eSpark-Backup/bryangilmore-ups/Design-Files/DC-UPS-v1.0/Deliverables/Renderings/3D_Isometric_View.PNG

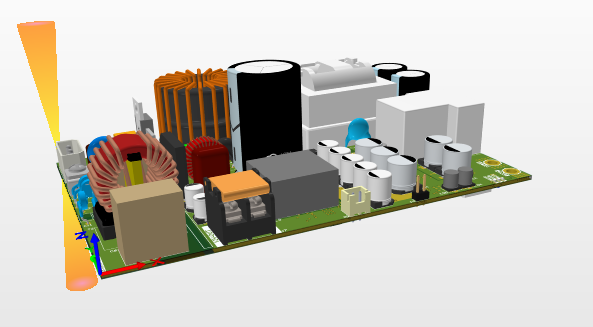
Design-Files/DC-UPS-v1.0/Deliverables/Renderings/3D_Isometric_View.PNG
