eSpark-Backup/bryangilmore-ups/Design-Files/DC-UPS-v1.0/Deliverables/Renderings/3D_Top_View.PNG

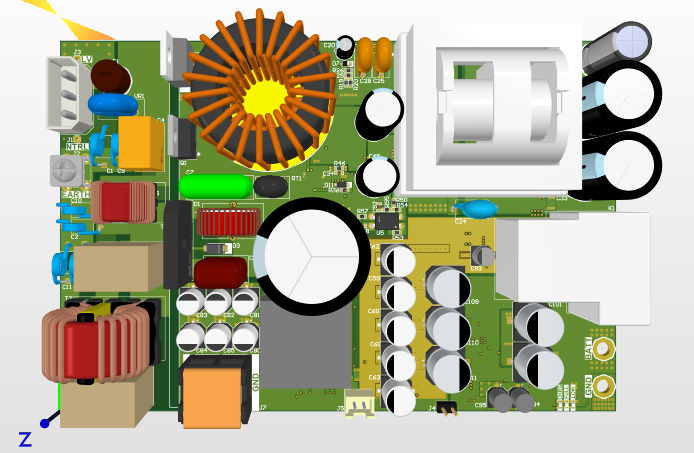
Design-Files/DC-UPS-v1.0/Deliverables/Renderings/3D_Top_View.PNG
