eSpark-Backup/bryangilmore-ups/Design-Files/DC-UPS-v1.0/Deliverables/Renderings/2D_C_View.PNG

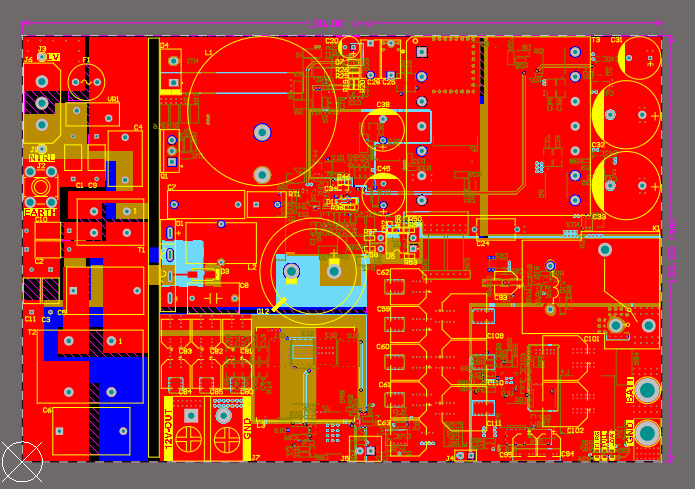
Design-Files/DC-UPS-v1.0/Deliverables/Renderings/2D_C_View.PNG
