eSpark-Backup/bryangilmore-ups/Design-Files/DC-UPS-v1.0/Deliverables/Renderings/2D_SIG+PWR_Layer.PNG

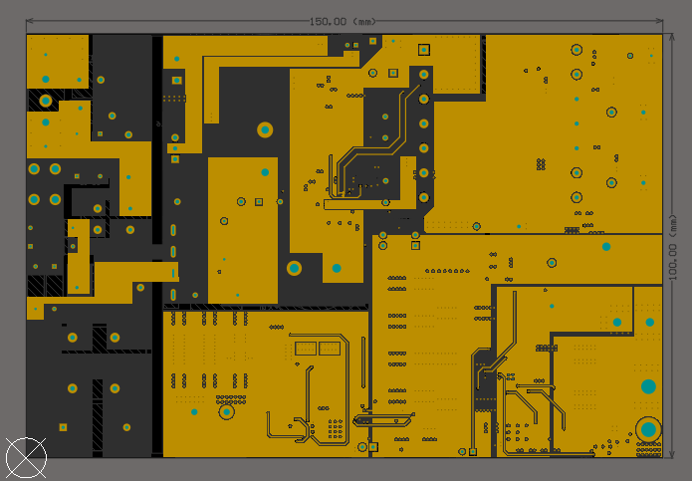
Design-Files/DC-UPS-v1.0/Deliverables/Renderings/2D_SIG+PWR_Layer.PNG
