eSpark-Backup/bryangilmore-ups/Design-Files/DC-UPS-v1.0/Deliverables/BOM/Client-BOM-DC-UPS-v1.0.xlsx

# | Item Type | Designator | Description | Footprint | Manufacturer Part Number | Manufacturer | Value | Quantity | Remarks
1 | Capacitors | C1, C9 | CAP CER 100PF 250V RADIAL | Custom | DE1B3RA101KN4AN01F | Murata | 100pF | 2
2 | Suppression Capacitor | C2, C3, C10, C11 | CAP CER 220PF 250V RADIAL | Custom | DE1B3RA221KN4AN01F | Murata | 220pF | 4
3 | Suppression Capacitor | C4 | 220nF ±10% X2 275V Plugin,P=10mm Suppression Capacitors ROHS | Custom | X2P2224KN1B0130150080ES0 | STE | 220nF | 1
4 | Capacitor | C5, C6 | CAP FILM 0.47UF 10% 560VDC RAD | Custom | R46KI347050M1K | KEMET | 0.47UF | 2
5 | Film Capacitors | C7 | CAP FILM 0.47UF 5% 450VDC RADIAL | Custom | 450MPK474J | Rubycon | 470nF | 1
6 | Capacitor | C8 | 1uF -40℃~+105℃ ±5% 450V Plugin,P=10mm Polypropylene Film Capacitors (CBB) ROHS | Custom | MPP105J2W10KN22605 | KNSCHA | 1uF | 1
7 | Capacitor | C12 | 20% 900mA@120Hz 10mm 450V 150uF Plugin,D25xL30mm Horn-Type Electrolytic Capacitors ROHS | Custom | KN151M45025*30A | KFSON | 150uF | 1
8 | Capacitor | C13 | CAP CER 10PF 1KV C0G/NPO 1206 | Cap-1206 | CC1206JKNPOCBN100 | Yageo | 10pF | 1
9 | Capacitor | C14 | CAP CER 0.1UF 50V X5R 0603 | Cap-0603 | CC0603KRX5R9BB104 | Yageo | 100nF | 1
10 | Capacitor | C15 | CAP CER 3900PF 25V X7R 0603 | Cap-0603 | CC0603KRX7R8BB392 | Yageo | 3.9nF | 1
11 | Capacitor | C16 | CAP CER 560PF 50V C0G/NP0 0603 | Cap-0603 | 06035A561JAT2A | Kyocera AVX | 560pF | 1
12 | Capacitor | C17 | CAP CER 0.47UF 25V X7R 1206 | Cap-1206 | 12063C474KAT2A | Kyocera AVX | 470nF | 1
13 | Capacitor | C18 | CAP CER 0.22UF 16V X7R 0603 | Cap-0603 | CC0603KRX7R7BB224 | Yageo | 0.22uF | 1
14 | Capacitor | C19, C74, C75, C76, C86, C89, C90, C98, C103, C105, C106 | CAP CER 0.1UF 50V X7R 0603 | CAP-0603 | CL10B104KB8NNNL | Samsung | 0.1uF | 11
15 | Capacitor | C20 | 10uF 50V ±20% 90mA@100kHz Plugin,D5xL11mm Aluminum Electrolytic Capacitors - Leaded ROHS | Custom | ERM1HM100D11OT | AISHI | 10uF | 1
16 | Capacitor | C21 | CAP CER 0.47UF 50V X7R 1206 | Cap-1206 | CC1206KKX7R9BB474 | Yageo | 0.47uF | 1
17 | Capacitor | C22 | CAP CER 10PF 50V X7R 0603 | Cap-0603 | C0603C100K5RACAUTO | KEMET | 10pF | 1
18 | Capacitor | C23 | CAP CER 1000PF 100V X7R 0603 | Cap-0603 | 06031C102KAT2A | Kyocera AVX | 1000pF | 1
19 | Capacitors | C24 | 2200 pF ±20% 250VAC Ceramic Capacitor E Radial, Disc | Custom | DE1E3RA222MA4BN01F | Murata | 2.2nF | 1
20 | Capacitor | C25, C28 | 22nF -40℃~+100℃ ±5% 630V Plugin,P=7.5mm Polypropylene Film Capacitors (CBB) ROHS | Custom | KP223J2J0701 | KYET | 22nF | 2
21 | Capacitor | C26, C27, C35, C36, C92 | CAP CER 4.7UF 50V X7R 1206 | Cap-1206 | UMK316AB7475KL-T | Taiyo Yuden | 4.7uF | 5
22 | Capacitor | C29 | CAP CER 150PF 630V C0G/NP0 1206 | Cap-1206 | GRM31A5C2J151JW01D | Murata | 150pF | 1
23 | Capacitor | C30 | CAP CER 100PF 1KV 5% NP0 1206 | Cap-1206 | GRM31A5C3A101JW01D | Murata | 100pF | 1
24 | Capacitor | C31 | CAP ALUM 680UF 20% 35V RADIAL TH | Custom | EEU-FR1V681B | Panasonic | 680uF | 1
25 | Capacitor | C32, C33 | 2200uF 35V ±20% Plugin,D16xL25mm Aluminum Electrolytic Capacitors - Leaded ROHS | Custom | ERF1VM222L25OT | AISHI | 2200uF | 2
26 | Capacitor | C34, C57 | CAP CER 0.047UF 50V X8R 0603 | Cap-0603 | CGA3E2X8R1H473M080AA | TDK | 47nF | 2
27 | Capacitor | C37, C41, C43 | CAP CER 0.1UF 50V X7R 1206 | Cap-1206 | CC1206KRX7R9BB104 | Yageo | 0.1uF | 3
28 | Capacitor | C38 | CAP ALUM 470UF 20% 35V RADIAL | Custom | EEU-FR1V471B | Panasonic | 470uF | 1
29 | Capacitor | C39 | CAP CER 2.2UF 50V X5R 1206 | Cap-1206 | CC1206KKX5R9BB225 | Yageo | 2.2uF | 1
30 | Capacitor | C40, C42, C46, C96 | CAP, 2.2µF, 35V, 10%, X5R, 0603 | Cap-0603 | GRM188R6YA225KA12D | Murata | 2.2uF | 4
31 | Capacitors | C44 | CAP CER 2.2UF 16V X7R 1206 | Cap-1206 | CC1206KKX7R7BB225 | Yageo | 2.2uF | 1
32 | Capacitor | C45 | 1000uF 35V ±20% Plugin,D10xL20mm Aluminum Electrolytic Capacitors - Leaded ROHS | Custom | ERR1VM102G20OT | AISHI | 1000uF | 1
33 | Capacitor | C47 | CAP CER 1UF 100V X7R 1206 | Cap-1206 | GRM31CR72A105KA01K | Murata | 1uF | 1
34 | Capacitor | C48, C49, C50 | CAP CER 4.7UF 16V X5R 0603 | Cap-0603 | CC0603KRX5R7BB475 | Yageo | 4.7uF | 3
35 | Capacitor | C51, C54 | CAP CER 10000PF 100V X7R 0603 | Cap-0603 | CC0603KRX7R0BB103 | Yageo | 10nF | 2
36 | Capacitor | C52 | CAP CER 100PF 50V C0G/NPO 0603 | Cap-0603 | CC0603JRNPO9BN101 | Yageo | 100pF | 1
37 | Capacitor | C53 | 50V 220pF X7R ±10% 0603 Multilayer Ceramic Capacitors MLCC - SMD/SMT ROHS | Cap-0603 | CS1608X7R221K500NRB | Samwha Capacitors | 220pF | 1
38 | Capacitor | C55, C88 | CAP CER 47PF 50V NPO 0603 | Cap-0603 | CC0603FRNPO9BN470 | Yageo | 47pF | 2
39 | Capacitor | C56 | CAP CER 4700PF 100V X7R 0603 | Cap-0603 | CC0603KRX7R0BB472 | Yageo | 4.7nF | 1
40 | Capacitor | ~~C58~~ | ~~CAP CER 47PF 50V NPO 0603~~ | ~~Cap-0603~~ | ~~CC0603FRNPO9BN470~~ | ~~Yageo~~ | ~~DNP~~ | ~~1~~ | ~~DO NOT MOUNT~~
41 | Capacitors | C59, C60, C61, C62, C63 | CAP ALUM POLY 18UF 20% 50V SMD | 50SVPF18M | 50SVPF18M | Panasonic | 18uF | 5
42 | Capacitor | C64, C65, C66, C67, C68, C69, C70, C71, C72, C73 | CAP CER 4.7UF 50V X5R 0805 | Cap-0805 | GRM21BR61H475KE51L | Murata | 4.7uf | 10
43 | Capacitors | C77 | CAP FILM 0.68UF 20% 16VDC 1206 | Cap-1206 | ECP-U1C684MA5 | Panasonic | 680nF | 1
44 | Capacitors | C78 | CAP CER 0.068UF 50V X7R 0603 | Cap-0603 | CC0603KRX7R9BB683 | Yageo | 68nF | 1
45 | Capacitor | C79 | CAP CER 2200PF 50V X7R 0603 | Cap-0603 | CC0603KRX7R9BB222 | Yageo | 2.2nF | 1
46 | Capacitors | C80, C81, C82, C83, C84, C85 | CAP ALUM POLY 270UF 20% 16V SMD | Custom | 16SVPG270M | Panasonic | 270uF | 6
47 | Capacitor | C87 | CAP CER 330PF 50V C0G/NPO 0603 | Cap-0603 | CC0603JRNPO9BN331 | Yageo | 330pF | 1
48 | Capacitor | C93 | 33uF 25V 30mA@120Hz ±20% SMD,D5xL5.4mm Aluminum Electrolytic Capacitors - SMD ROHS | Custom | RVT1E330M0505 | ROQANG | 33uF | 1
49 | Capacitor | C94, C95 | CAP ALUM 15UF 20% 35V SMD | Custom | UUD1V150MCL1GS | Nichicon | 15uF | 2
50 | Capacitor | C97, C99, C100, C107 | CAP CER 1UF 50V X5R 0603 | Cap-0603 | CL10A105KB8NNNC | Samsung | 1uF | 4
51 | Capacitors | C101, C102, C109, C110, C111 | CAP ALUM POLY 68UF 20% 50V SMD | Custom | 50SVPF68M | Panasonic | 68uF | 5
52 | Capacitor | C104 | CAP CER 22PF 50V C0G/NPO 0402 | Cap-0402 | CC0402JRNPO9BN220 | Yageo | 22PF | 1
53 | Capacitor | C108 | CAP CER 100PF 50V C0G/NPO 0402 | Cap-0402 | CC0402JRNPO9BN101 | Yageo | 100pF | 1
54 | Diode | D1 | BRIDGE RECT 1PHASE 600V 8A GBU | GBU | GBU806 | Diodes | - | 1
55 | Diode | D2, D3 | DIODE GEN PURP 600V 1A SMA | SMA | MURA160T3G | ON Semiconductor | - | 2
56 | Diode | D4 | DIODE GEN PURP 600V 8A TO220FPAC | TO-220-2 | STTH8L06FP | STMicroelectronics | - | 1
57 | Diode | D5, D6, D8, D9 | 100V 1V@10mA 4ns 200mA SOD-323 Switching Diodes ROHS | SOD-323 | MMDL914-TP | MCC | - | 4
58 | Diode | D7 | DIODE GEN PURP 75V 150MA SOD323 | SOD-323 | 1N4148WS-7-F | Diodes | - | 1
59 | Diode | D10 | DIODE SCHOTTKY 60V 1A SMB | SMB_ | STPS160UY | STMicroelectronics | - | 1
60 | Diode | D11 | DIODE ZENER 6.2V 500MW SOD123 | SOD-123 | MMSZ5234B-7-F | Diodes | - | 1
61 | Diode | D12 | 1.65V@1A 35ns Independent Type 1A 600V DO-214AD Fast Recovery / High Efficiency Diodes ROHS | DO-214AD | ES1JF | Foshan Blue Rocket Elec | - | 1
62 | Diode | D13, D17 | DIODE GEN PURP 100V 300MA SOD123 | SOD-123 | 1N4148W-7-F | Diodes | - | 2
63 | Diode | D14, D15 | 35V Independent Type 500mV@200mA 200mA SOD-523F Schottky Diodes ROHS | SOD-523F | CDBUR0230L-HF | Comchip | - | 2
64 | Diode | D16 | 20V 385mV@0.5A 500mA SOD-123 Schottky Diodes ROHS | SOD-123F | B0520W | SINEDEVICE | - | 1
65 | Diode | D18 | 45V Independent Type 20A 470mV@20A TO-277 Schottky Diodes ROHS | TO-277 | ST2045 | MDD | - | 1
66 | Diode | D19 | 40V 500mV@2A 2A SMA(DO-214AC) Schottky Barrier Diodes (SBD) ROHS | SMA | SS24A | Guangdong Hottech | - | 1
67 | Fuses | F1 | FUSE BOARD MNT 5A 250VAC RADIAL | Custom | 37215000001 | Littelfuse Wickmann | - | 1
68 | Terminal Block | J2 | M4 Plugin PCB Welding Terminal ROHS | Custom | T44001 | XFCN | - | 1
69 | Male Header | J4 | Gold 250V 3A Straight Square Pins 2.5mm 2P 260℃ 6mm -40℃~+105℃ 3mm 2.54mm Plugin Black Brass 1x2P Plugin,P=2.54mm Pin Headers ROHS | HDR1X2_ | X6511WV-02H-C60D30 | XKB | - | 1
70 | JST Connector | J5 | Conn Shrouded Header (4 Sides) HDR 2 POS 2.5mm Solder ST Thru-Hole Box | Custom | B2B-XH-A(LF)(SN) | JST | - | 1
71 | Wire To Board Connector | J6 | 1x3P 3P 1 Tin 5.08mm 3 Brass 10A Direct Insert Plugin,P=5.08mm Wire To Board Connector ROHS | Custom | X5050WV-03-N2SN | XKB Connection | - | 1
72 | Terminal Block | J7 | 1x2P Corner With Cover Plate 2 1 7.62mm -40℃~+105℃ 20A 300V Black 12~22 Straight Needle Plugin,P=7.62mm Barrier Terminal Blocks ROHS | Custom | DBT50G-7.62-2P-BK-P | DORABO | - | 1
73 | Relays | K1 | 12V 40A One Conversion: 1C (SPDT-Conversion) Plugin,27.2x32mm Power Relays ROHS | Custom | NB90-12S-S-C | NBC | - | 1
74 | Inductor | L1 | 20A 85uH ±15% 10A Plugin,D=35mm Power Inductors ROHS | Custom | FC-PFC1060-850M-B-L | FANGCHENG | 85uH | 1
75 | Inductors | L2 | FIXED IND 100UH 2A 80 MOHM TH | Custom | 7447021 | Wurth Electronics | 100uH | 1
76 | Inductors | L3 | 60A 1uH ±20% 60A SMD,23.5x22mm Power Inductors ROHS | Custom | FXL2213-1R0-M | cjiang | 1uH | 1
77 | Inductors | L4 | 23A 1.5uH Integrated molded inductor ±20% 33A SMD,12.6x13.5mm Power Inductors ROHS | Custom | FAUL1350-1R5MT | cjiang | 1.5uH | 1
78 | LED | LED1 | RED LED 0603 Light Emitting Diodes | LED-0603 | NCD0603R3 | Foshan NationStar Optoelectronics | - | 1
79 | LED | LED2 | Emerald 0603 Light Emitting Diodes (LED) ROHS | LED-0603 | NCD0603G2 | Foshan NationStar Optoelectronics | - | 1
80 | LED | LED3 | 20mA 100mcd~220mcd 600nm~610nm -30℃~+85℃ Orange 130° 65mW 1.6V~2.6V 0603 Light Emitting Diodes (LED) ROHS | LED-0603 | NCD0603O2 | FOSHAN Nationstar Optoelectronics | - | 1
81 | MOSFET | Q1 | MOSFET N-CH 600V 31A TO220-3 | TO-220-3 | IPP60R099P7XKSA1 | Infineon | - | 1
82 | MOSFET | Q2 | 650V 190mΩ@10V 3.5V 1PCSNChannel TO-263 MOSFETs ROHS | TO-263 | STB24NM60N-VB | VBsemi Elec | - | 1
83 | MOSFETs | Q3 | MOSFET P-CH 60V 1.6A SOT23-3 | SOT-23 | SI2309CDS-T1-E3 | Vishay Siliconix | - | 1
84 | BJTs | Q4 | TRANS NPN 40V 0.6A SOT23-3 | SOT-23 | MMBT4401-7-F | Diodes | - | 1
85 | MOSFET | Q5, Q7 | MOSFET N-CH 800V 21A D2PAK | TO-263 | SIHB24N80AE-GE3 | Vishay | - | 2
86 | Mosfet | Q6, Q9 | MOSFET N-CH 80V 100A 8VSON | 8-VSONP (5x6) | CSD19502Q5B | Texas Instruments | - | 2
87 | IC | Q10 | MOSFET N-CH 40V 159A 8VSON | 8-VSONP (5x6) | CSD18511Q5A | Texas Instruments | - | 1
88 | MOSFETs | Q11, Q13 | MOSFET N-CH 100V 100A 8VSON | 8-VSONP (5x6) | CSD19533Q5A | Texas Instruments | - | 2
89 | MOSFETs | Q12 | MOSFET N-CH 60V 19A/100A 8VSON | 8-VSONP (5x6) | CSD18531Q5A | Texas Instruments | - | 1
90 | Mosfet | Q14, Q15, Q18, Q19 | 40V 100mW 100@10mA,1V 200mA 300MHz 300mV@50mA,5mA NPN -55℃~+150℃@(Tj) SOT-723 Bipolar Transistors - BJT ROHS | SOT-723 | MMBT3904M | TECH PUBLIC | - | 4
91 | MOSFETs | Q16, Q17 | MOSFET N-CH 40V 30A PPAK SO-8 | PowerPAK-SO-8 | SIR426DP-T1-GE3 | Vishay | - | 2
92 | Resistor | R1, R4 | RES 3.09M OHM 1% 1/4W 1206 | Res-1206 | RC1206FR-073M09L | Yageo | 3.09MR | 2
93 | Resistor | R2, R23 | RES SMD 10 OHM 1% 1/2W 0805 | RES-0805 | CRCW080510R0FKEAHP | Vishay | 10R | 2
94 | Resistor | R3, R7, R8, R11 | RES 3.3M OHM 1% 1/4W 1206 | Res-1206 | RC1206FR-073M3L | Yageo | 3.3MR | 4
95 | Resistor | R5 | RES SMD 1 OHM 1% 1/10W 0603 | Res-0603 | CRCW06031R00FKEA | Vishay Dale | 1R | 1
96 | Resistor | R6 | RES 82.5K OHM 1% 1/10W 0603 | Res-0603 | RC0603FR-0782K5L | Yageo | 82.5K | 1
97 | Resistor | R9 | RES SMD 1M OHM 1% 1/10W 0603 | Res-0603 | RC0603FR-071ML | Yageo | 1M | 1
98 | Resistors | R10 | RES 24.3K OHM 1% 1/10W 0603 | Res-0603 | RC0603FR-0724K3L | Yageo | 24.3K | 1
99 | Resistor | R12 | RES 3K OHM 1% 1/10W 0603 | Res-0603 | RC0603FR-073KL | Yageo | 3K | 1
100 | Resistor | R13, R14, R15, R16 | Res Thick Film 1206 0.1 Ohm 1% 1/2W ±100ppm/°C Molded SMD SMD Paper T/R | Res-1206 | CSR1206FTR100 | Stackpole Electronics | 0.1R | 4
101 | Resistor | R17 | RES SMD 100K OHM 1% 1/10W 0603 | Res-0603 |  |  | 100K | 1
102 | Resistor | R18, R25 | RES 75K OHM 1% 1/10W 0603 | Res-0603 | RC0603FR-0775KL | Yageo | 75K | 2
103 | Resistor | R19 | RES 36.5K OHM 1% 1/10W 0603 | Res-0603 | RC0603FR-0736K5L | YAGEO | 36.5K | 1
104 | Resistor | R20 | 100mW Thick Film Resistors 75V ±100ppm/℃ ±1% 120kΩ 0603 Chip Resistor - Surface Mount ROHS | RES-0603 | 0603WAF1203T5E | UNI-ROYAL(Uniroyal Elec) | 120K | 1
105 | Resistor | R21 | RES 49.9K OHM 1% 1/10W 0603 | Res-0603 | RC0603FR-0749K9L | Yageo | 49K9 | 1
106 | Resistor | R22, R26 | RES 390K OHM 1% 1/10W 0603 | Res-0603 | RC0603FR-07390KL | Yageo | 390K | 2
107 | Resistors | R24 | RES 274K OHM 1% 1/10W 0603 | Res-0603 | RC0603FR-07274KL | Yageo | 274K | 1
108 | Resistor | R27, R29 | RES 10K OHM 1% 1/4W 0805 | RES-0805 | RC0805FR-7W10KL | Yageo | 10K | 2
109 | Resistor | R28, R30, R66, R81 | RES SMD 10 OHM 1% 1/10W 0603 | Res-0603 | RC0603FR-0710RL | Yageo | 10R | 4
110 | Resistor | R31 | RES SMD 0 OHM JUMPER 1/4W 1206 | Res-1206 | CRCW12060000Z0EA | Vishay | 0R | 1
111 | Resistor | R32 | RES SMD 36.5KOHM 0.1% 1/10W 0603 | Res-0603 | RT0603BRE0736K5L | Yageo | 36.5K | 1
112 | Resistor | R33 | RES SMD 8.45KOHM 0.1% 1/10W 0603 | Res-0603 | RT0603BRD078K45L | Yageo | 8.45K | 1
113 | Resistors | R34, R35, R37, R38 | RES 0 OHM JUMPER 1/16W 0402 | Res-0402 | RC0402FR-070RL | Yageo | 0R | 4
114 | Resistor | R36, R69, R83 | RES SMD 10K Ohm 1% 1/10W 0603 | Res-0603 | RC0603FR-0710KL | Yageo | 10K | 3
115 | Resistors | R39, R41, R45 | RES 4.99M OHM 1% 1/4W 1206 | Res-1206 | RC1206FR-074M99L | Yageo | 4.99MR | 3
116 | Resistors | R40 | RES 2.2 OHM 1% 1/10W 0603 | Res-0603 | RC0603FR-072R2L | Yageo | 2.2R | 1
117 | Resistor | R42, R43, R44 | RES 1.65K OHM 1% 1/4W 1206 | Res-1206 | RC1206FR-071K65L | Yageo | 1.65K | 3
118 | Resistor | R46 | RES SMD 806K OHM 1% 1/10W 0603 | Res-0603 | CRCW0603806KFKEA | Vishay | 806K | 1
119 | Resistor | R47, R55 | RES 150K OHM 1% 1/10W 0603 | Res-0603 | CRCW0603150KFKEA | Vishay | 150K | 2
120 | Resistor | R48, R73, R74, R93 | RES SMD 100 OHM 1% 1/10W 0603 | Res-0603 | RC0603FR-07100RL | Yageo | 100R | 4
121 | Resistor | R49 | RES SMD 44.2K OHM 1% 1/10W 0603 | Res-0603 | CRCW060344K2FKEA | Vishay | 44.2K | 1
122 | Resistors | R50 | RES SMD 20 OHM 1% 1/10W 0603 | Res-0603 | CRCW060320R0FKEA | Vishay | 20R | 1
123 | Resistor | R51, R52 | RES 0 OHM JUMPER 1W 2512 | RES-2512 | RC2512JK-070RL | Yageo | 0R | 2
124 | Resistor | R53 | RES 1.5K OHM 1% 1/10W 0603 | Res-0603 | RC0603FR-071K5L | Yageo | 1.5K | 1
125 | Resistor | R54 | RES 6.04K OHM 1% 1/10W 0603 | Res-0603 | RC0603FR-076K04L | Yageo | 6.04K | 1
126 | Resistor | R56 | RES 25.5K OHM 1% 1/10W 0603 | Res-0603 | RC0603FR-0725K5L | Yageo | 25.5K | 1
127 | Resistor | R57 | RES 0 OHM JUMPER 1/10W 0603 | Res-0603 | RC0603JR-070RL | Yageo | 0R | 1
128 | Resistor | R58 | RES 17.4K OHM 1% 1/10W 0603 | Res-0603 | RC0603FR-0717K4L | Yageo | 17.4K | 1
129 | Resistor | R59 | 62.5mW Thick Film Resistors 50V ±100ppm/℃ ±1% 249kΩ 0402 Chip Resistor - Surface Mount ROHS | Res-0402 | 0402WGF2493TCE | Royal Electronic Factory | 249K | 1
130 | Resistors | R60 | RES SMD 280K OHM 0.1% 1/10W 0603 | Res-0603 | RT0603BRD07280KL | Yageo | 280K | 1
131 | Resistor | R61 | RES 2K OHM 1% 1/16W 0402 | Res-0402 | RC0402FR-072KL | Yageo | 2K | 1
132 | Resistors | R65 | RES 287K OHM 1% 1/16W 0402 | Res-0402 | RC0402FR-07287KL | Yageo | 287K | 1
133 | Resistor | R67 | RES SMD 20K OHM 0.1% 1/10W 0603 | Res-0603 | RT0603BRD0720KL | Yageo | 20K | 1
134 | Resistors | R68 | RES 0.0015 OHM 1% 10W 5931 | 5931 | WSLP59311L500FEB | Vishay Dale | 1.5mR | 1
135 | Resistors | R70 | RES 93.1K OHM 1% 1/10W 0603 | Res-0603 | RC0603FR-0793K1L | Yageo | 93.1K | 1
136 | Resistor | R71 | RES SMD 5.36K OHM 1% 1/10W 0603 | Res-0603 | CRCW06035K36FKEA | Vishay | 5.36K | 1
137 | Resistors | R72 | RES 28.7K OHM 1% 1/20W 0201 | Res-0201 | RC0201FR-0728K7L | Yageo | 28.7K | 1
138 | Resistor | R75, R77, R87 | RES 10K OHM 1% 1/16W 0402 | Res-0402 | RC0402FR-0710KL | Yageo | 10K | 3
139 | Resistor | R76, R78, R88 | RES 100K OHM 1% 1/16W 0402 | Res-0402 | RC0402FR-07100KL | Yageo | 100K | 3
140 | Resistors | R79 | RES SMD 56K OHM 0.1% 1/16W 0402 | Res-0402 | RT0402BRD0756KL | Yageo | 56K | 1
141 | Resistors | R80 | RES SMD 2K OHM 1% 1/10W 0603 | Res-0603 | RC0603FR-072KL | Yageo | 2K | 1
142 | Resistor | R82, R86, R89 | RES SMD 100K OHM 0.1% 1/10W 0603 | Res-0603 | RT0603BRD07100KL | Yageo | 100K | 3
143 | Resistor | R84 | RES 0.01 OHM 1% 3W 2512 | RES-2512 | PA2512FKE7T0R01E | Yageo | 10mR | 1
144 | Resistors | R85 | RES SMD 93.1KOHM 0.1% 1/10W 0603 | Res-0603 | RT0603BRD0793K1L | Yageo | 93.1K | 1
145 | Resistor | ~~R90~~ | ~~RES 0 OHM JUMPER 1/10W 0603~~ | ~~Res-0603~~ | ~~RC0603JR-070RL~~ | ~~Yageo~~ | ~~DNP~~ | ~~1~~ | ~~DO NOT MOUNT~~
146 | Resistor | R91, R97 | RES 1.5K OHM 1% 1/16W 0402 | Res-0402 | RC0402FR-071K5L | Yageo | 1.5K | 2
147 | Resistors | R92 | RES SMD 9.31KOHM 0.1% 1/10W 0603 | Res-0603 | RT0603BRE079K31L | Yageo | 9.31K | 1
148 | Resistors | R94 | RES SMD 430K OHM 0.1% 1/10W 0603 | Res-0603 | RT0603BRD07430KL | Yageo | 430K | 1
149 | Resistor | R95 | 50mW Thick Film Resistors ±5% ±200ppm/℃ 68Ω 0201 Chip Resistor - Surface Mount ROHS | Res-0201 | 0201WMJ0680TEE | UNI-ROYAL | 68R | 1
150 | Resistor | R96 | 50mW Thick Film Resistors ±1% ±200ppm/℃ 22kΩ 0201 Chip Resistor - Surface Mount ROHS | Res-0201 | 0201WMF2202TEE | UNI-ROYAL | 22K | 1
151 | Thermistors | RT1 | ICL 10 OHM 20% 3A 9.5MM | Custom | B57235S0100M000 | TDK EPCOS | 10R | 1
152 | Inductor | T1 | CMC 1MH 3A 2LN TH | Custom | 744822301 | Wurth Electronics | - | 1
153 | Common Mode Chokes | T2 | CMC 10MH 3A 2LN TH | Custom | 744824310 | Wurth Electronics | - | 1
154 | Transformer | T3 | XFMR RES CONV AC/DC 500UH TH | Custom | 760895631 | Wurth Electronics | - | 1
155 | IC | U1 | IC PFC CTRLR TRANSITION SOT23-6 | SOT-23-6 | UCC28056DBVT | Texas Instruments | - | 1
156 | IC | U2, U3 | SYNC RECTIFIER FLYBACK | SOT-23-5 | UCC24612-2DBVR | Texas Instruments | - | 2
157 | IC | U4 | HALF BRIDGE CONT WITH HV DRIVER | Custom | UCC256404DDBR | Texas Instruments | - | 1
158 | Optocouplers | U5 | Optocoupler DC-IN 1-CH Transistor DC-OUT 4-Pin PDIP | DIP-4 | VO618A-3 | Vishay Semiconductors | - | 1
159 | IC | U6 | IC VREF SHUNT ADJ 1% SOT23-3 | SOT-23 | TLVH431AQDBZR | Texas Instruments | - | 1
160 | IC | U7 | IC POWER REGULATOR | HTSSOP-28-EP | LM5176QPWPRQ1 | Texas Instruments | - | 1
161 | IC | U9 | IC OSC SGL TIMER 100KHZ 8-SOIC | SOIC-8 | NA555DR | Texas Instruments | - | 1
162 | IC | U10 | IC BATT CHG LI-ION 1-6CEL 16VQFN | QFN-16-EP(3.6x3.6) | BQ24600RVAR | Texas Instruments | - | 1
163 | IC | U11 | Active Low 1 VSOF-5 Monitors & Reset Circuits ROHS | 5-VSOF | BD4830FVE-TR | Rohm | - | 1
164 | Varistors | VR1 | VARISTOR 430V 3.5KA DISC 10MM | Custom | B72210S2271K101 | TDK EPCOS | - | 1
165 | Peripheral | - | Plugin AC Power Connectors ROHS | Custom | RT-C14-L00B-AA-09 | Legion | - | 1
