eSpark-Backup/bryangilmore-ups/(list of files, cad)

Other CAD files:
Design-Files/DC-UPS-v1.0/Deliverables/Supporting_Files/DC-UPS-v1.0.DWG
