eSpark-Backup/bryangilmore-ups/Design-Files/DC-UPS-v1.0/Deliverables/Schematics/Schematic_DC-UPS-v1.0.pdf

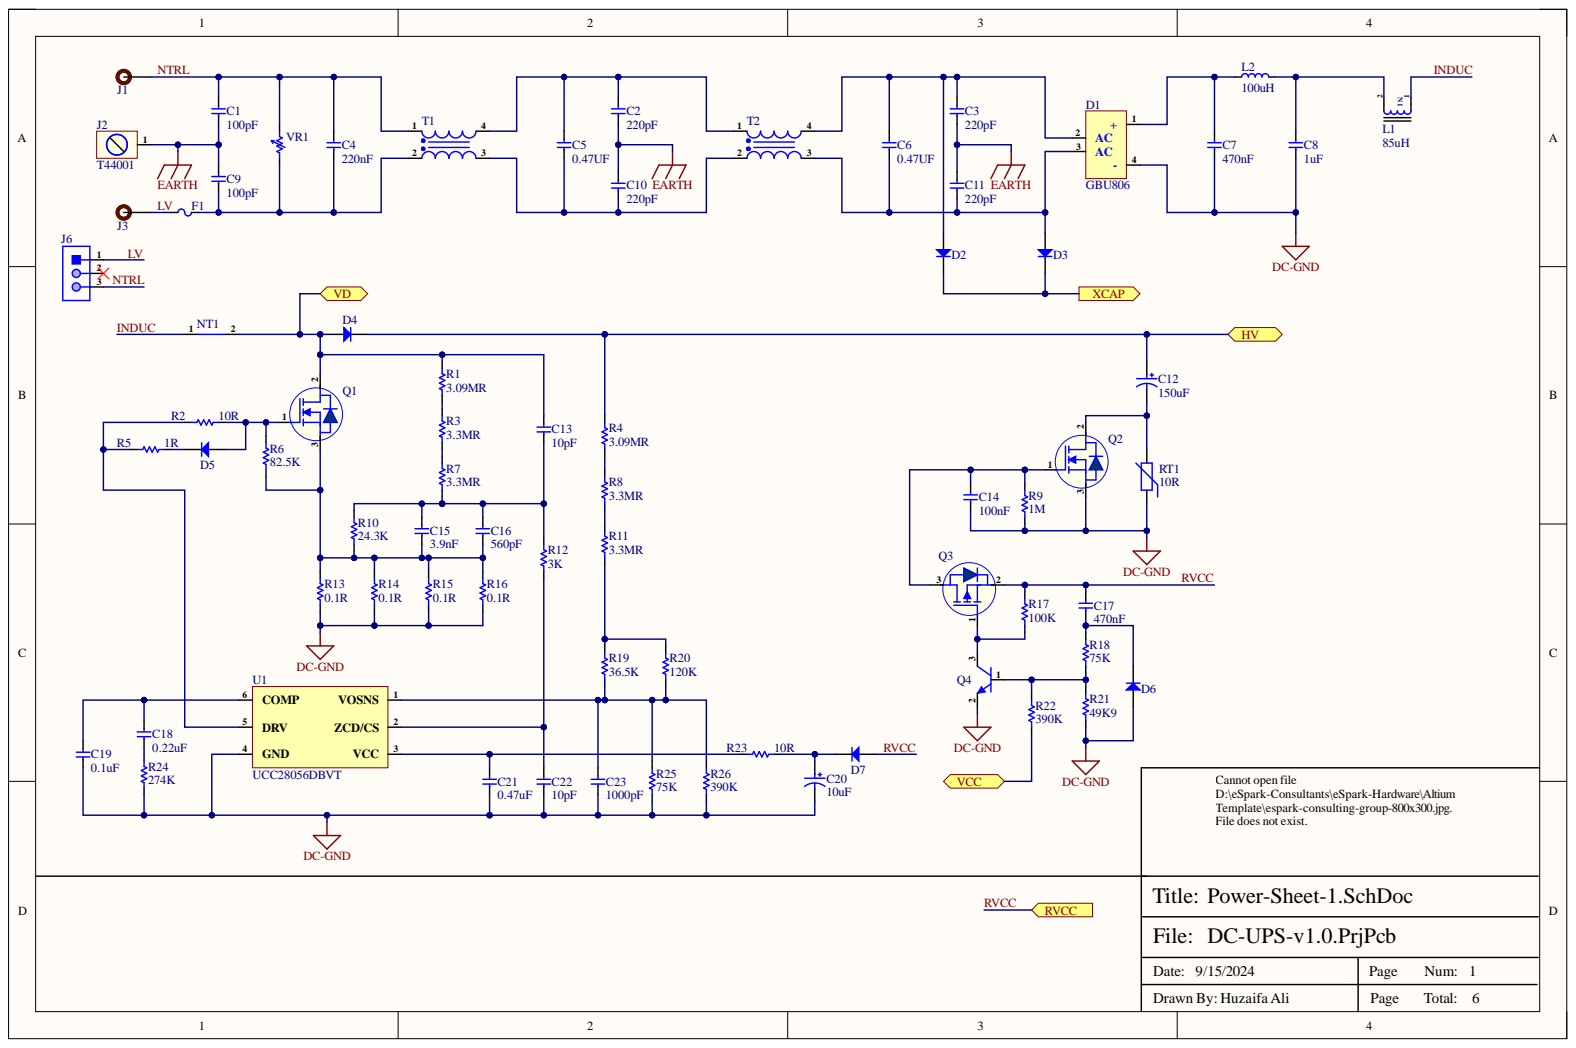
[picture p9: page 1]

Cannot open file
D:\eSpark-Consultants\eSpark-Hardware\Altium
Template\espark-consulting-group-800x300.jpg.
File does not exist.

Date: 9/15/2024 | Page Num: 1

Drawn By: Huzaifa Ali | Page Total: 6

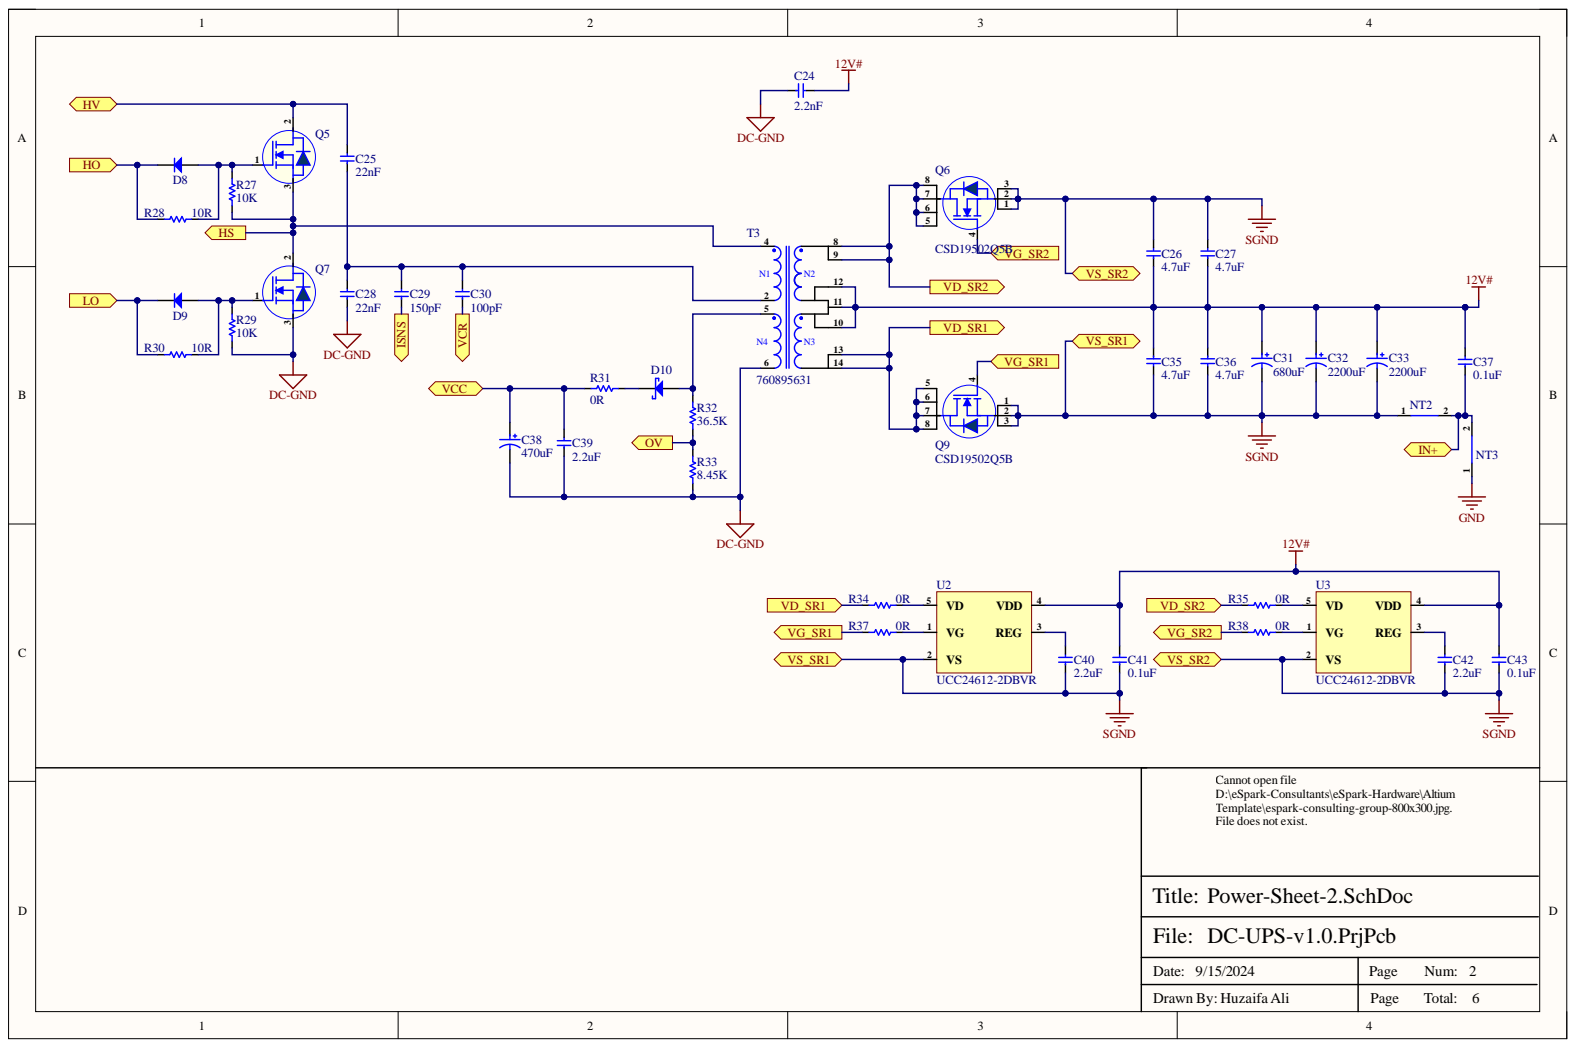
[picture p10: page 2]
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

Date: 9/15/2024 | Page Num: 2

Drawn By: Huzaifa Ali | Page Total: 6

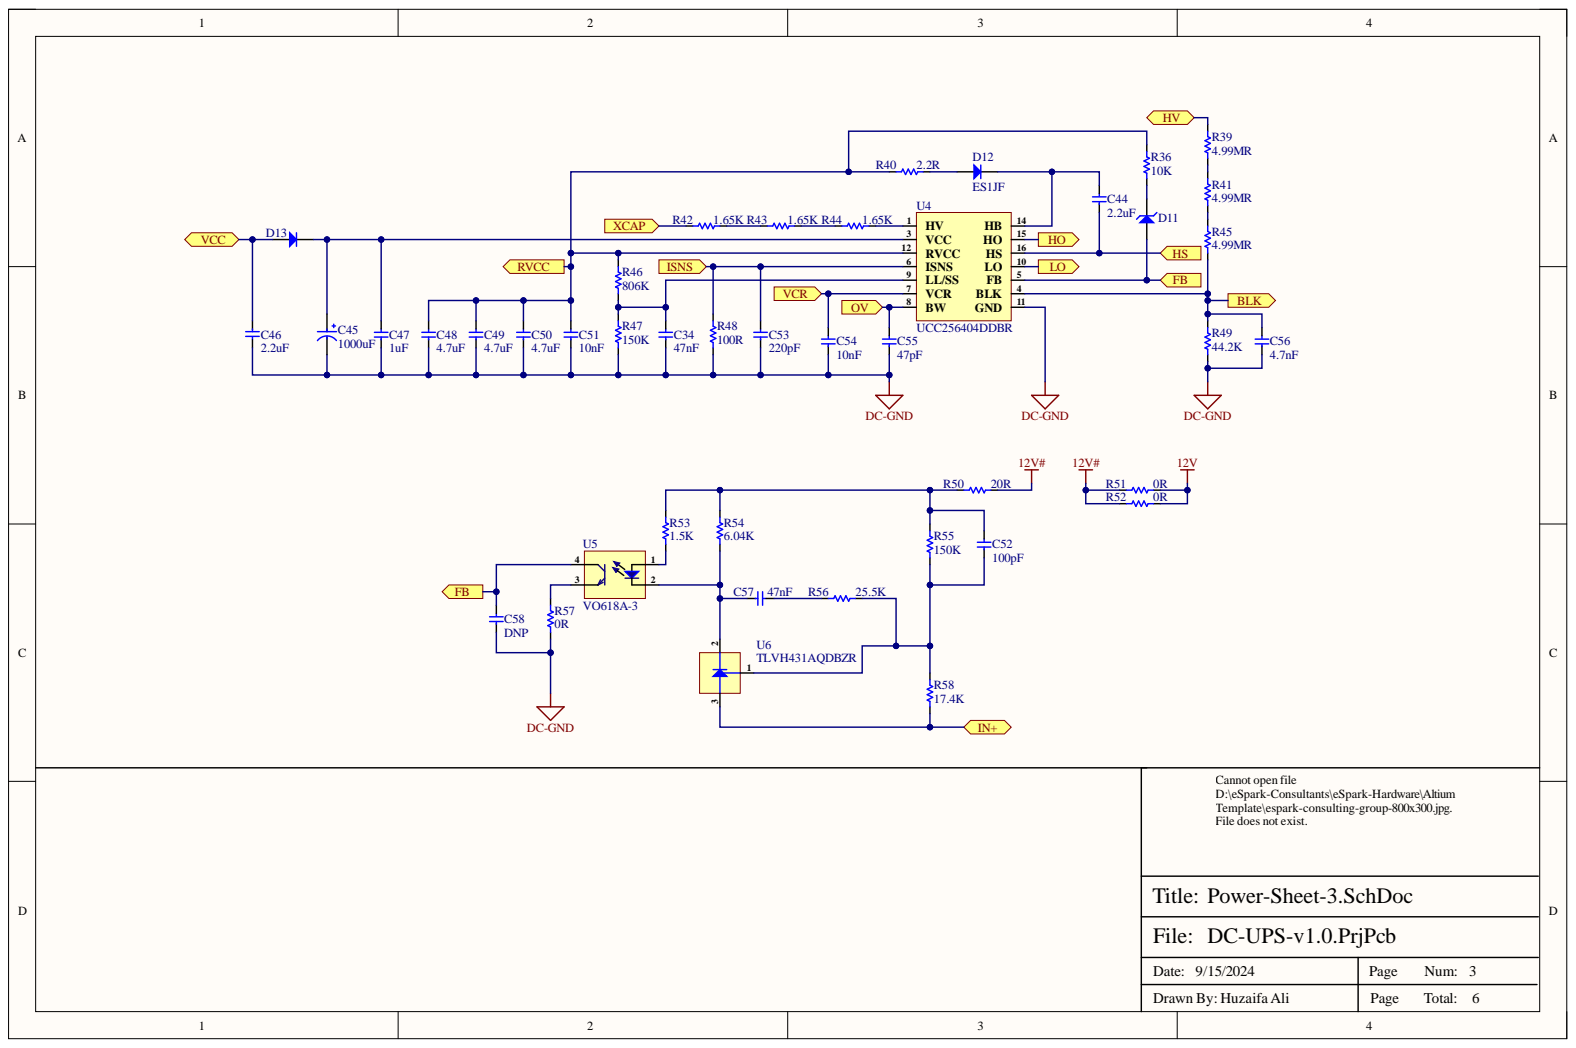
[picture p11: page 3]
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

Date: 9/15/2024 | Page Num: 3

Drawn By: Huzaifa Ali | Page Total: 6

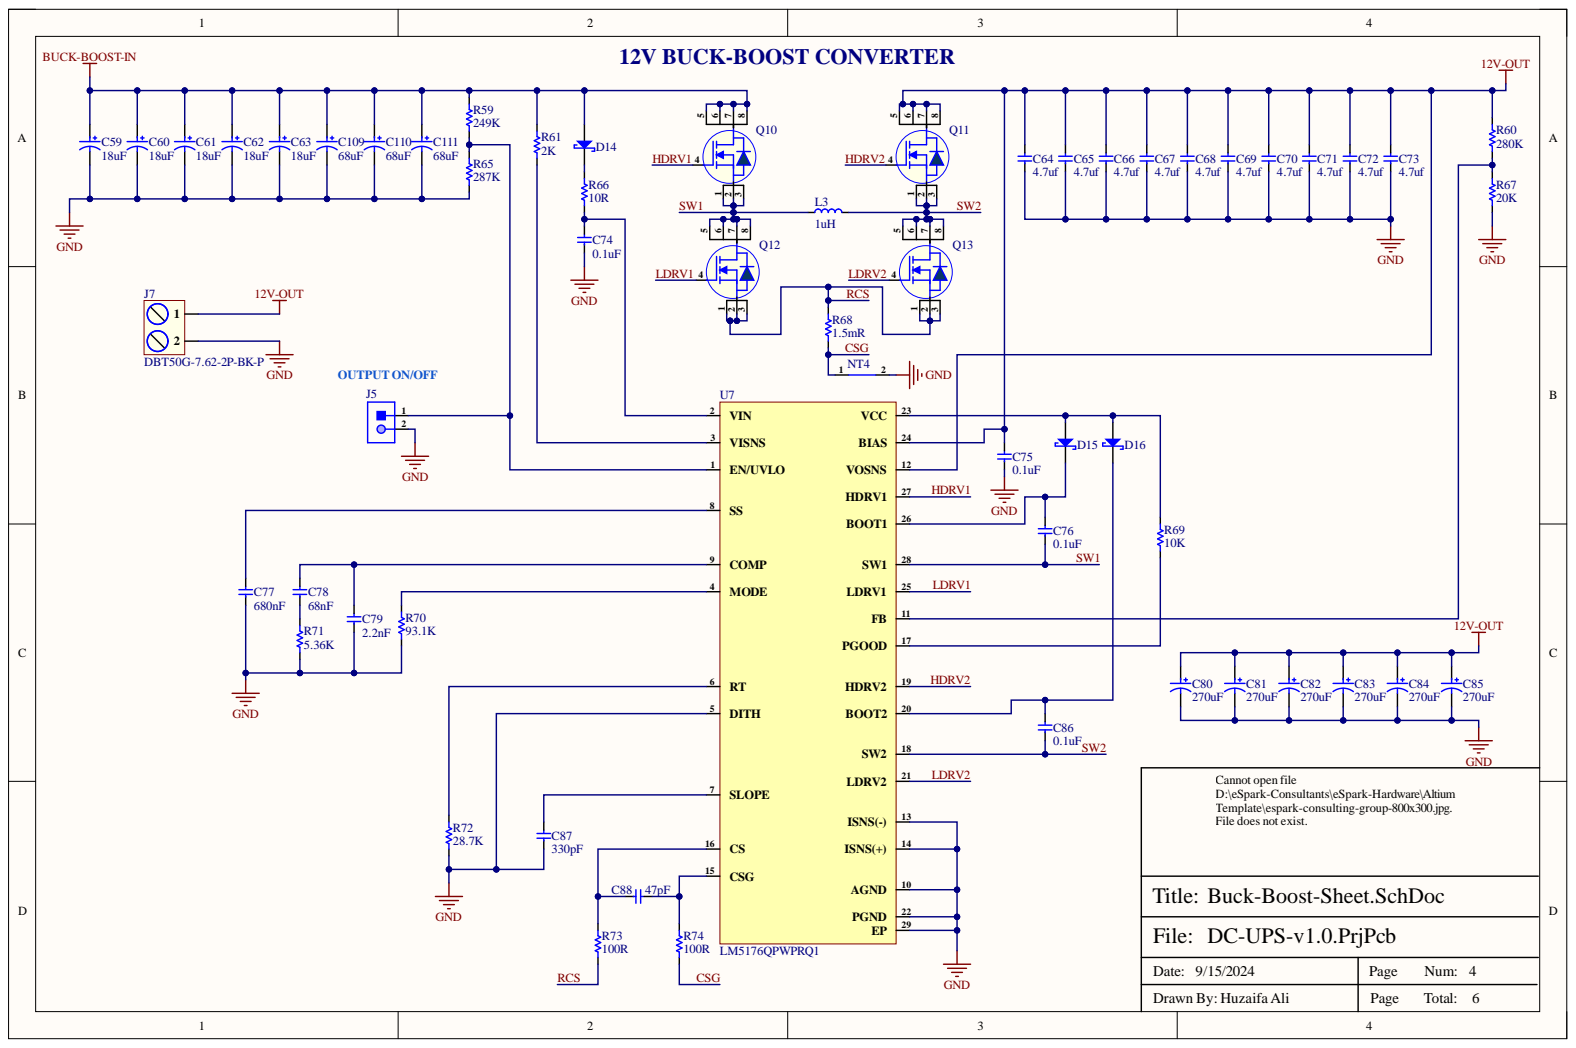
[picture p12: page 4]

2K | D14 HDRV1 4

GND | R66 10R

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

Buck-Boost-Sheet.SchDoc

Date: 9/15/2024 | Page Num: 4

Drawn By: Huzaifa Ali | Page Total: 6

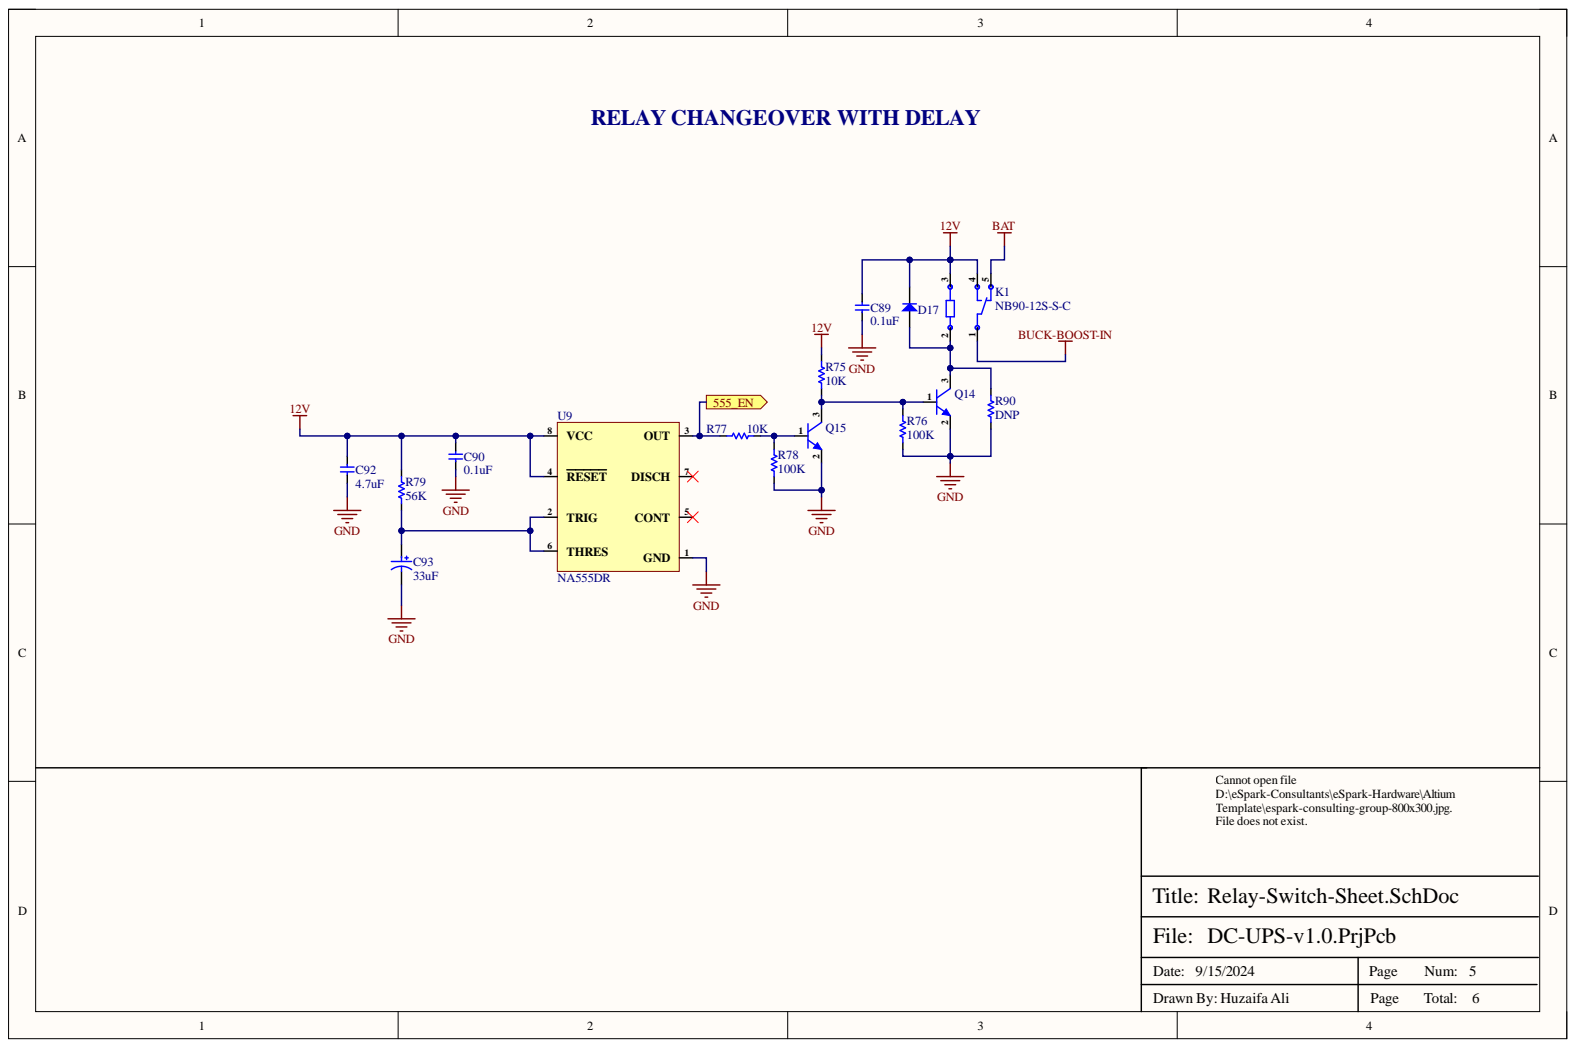
[picture p13: page 5]

Relay-Switch-Sheet.SchDoc

Dat e : 9 / 1 5 / 2 0 2 4 | Pag e N u m : 56

D raw n B y : H uzai fa A l i | Pag e To t al :

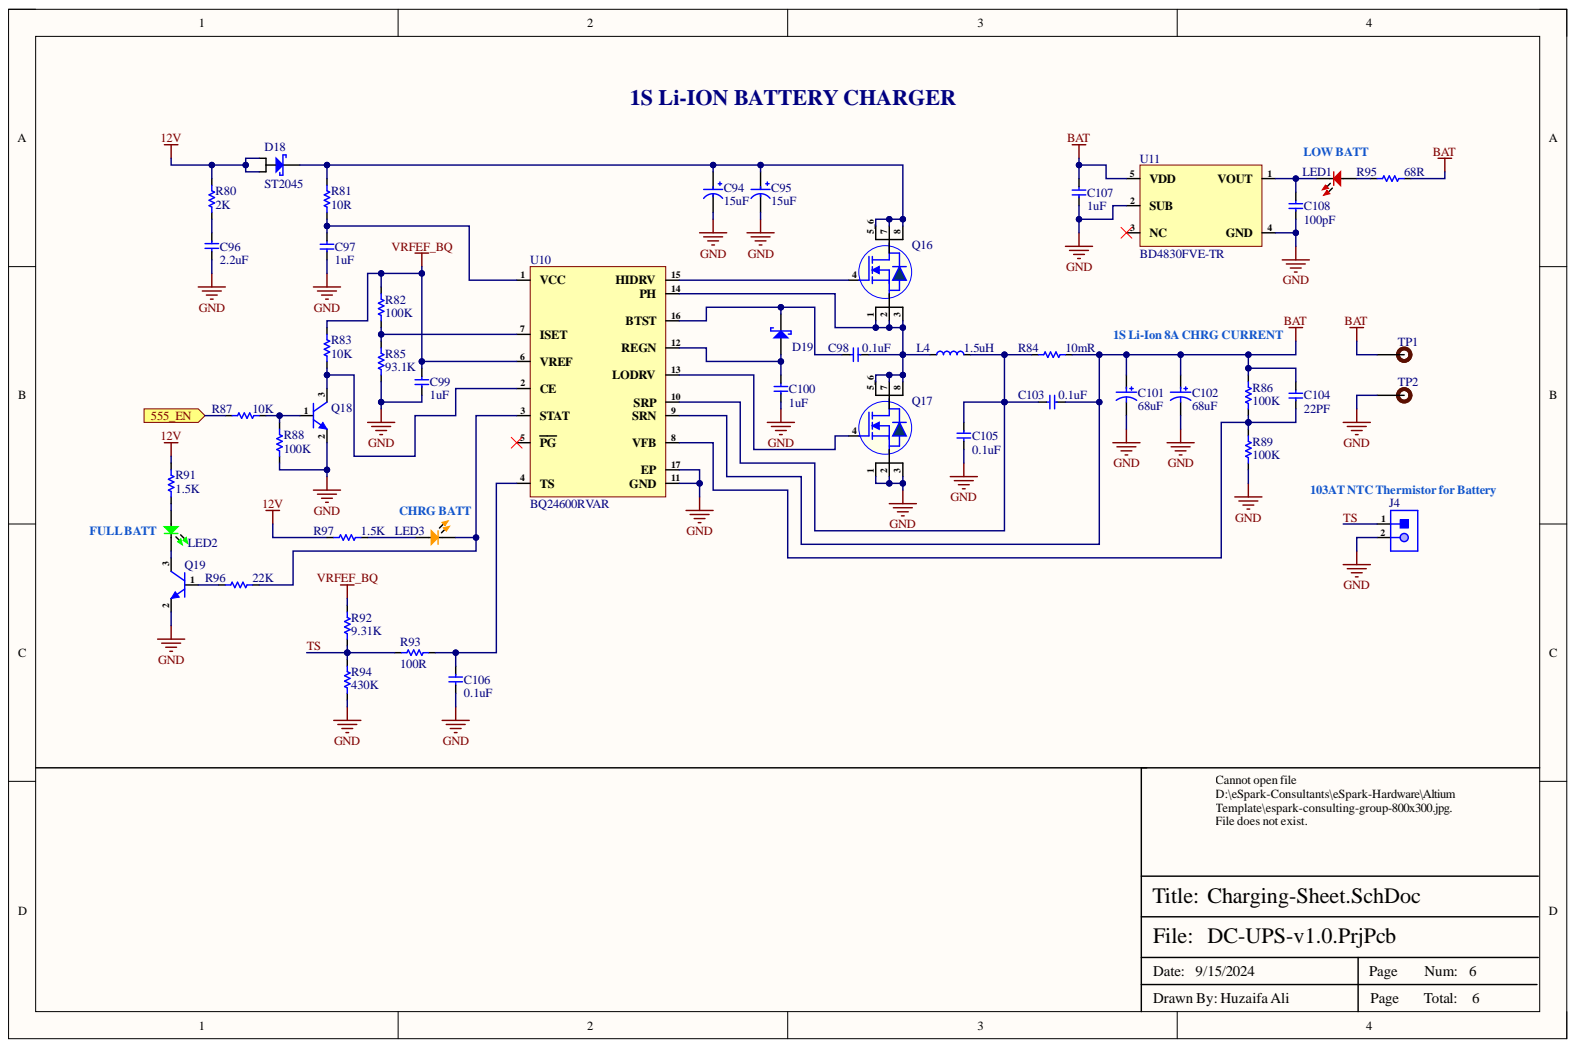
[picture p14: page 6]

Li-Ion 8A CHRG CURRENT

VR FEF_B Q

Dat e : 9 / 1 5 / 2 0 2 4 | Pag e N u m : 66

D raw n B y : H uzai fa A l i | Pag e To t al :
