eSpark-Backup/bryangilmore-ups/Design-Files/DC-UPS-v1.0/Deliverables/Schematics/Assembly_Drawings-v1.0.pdf

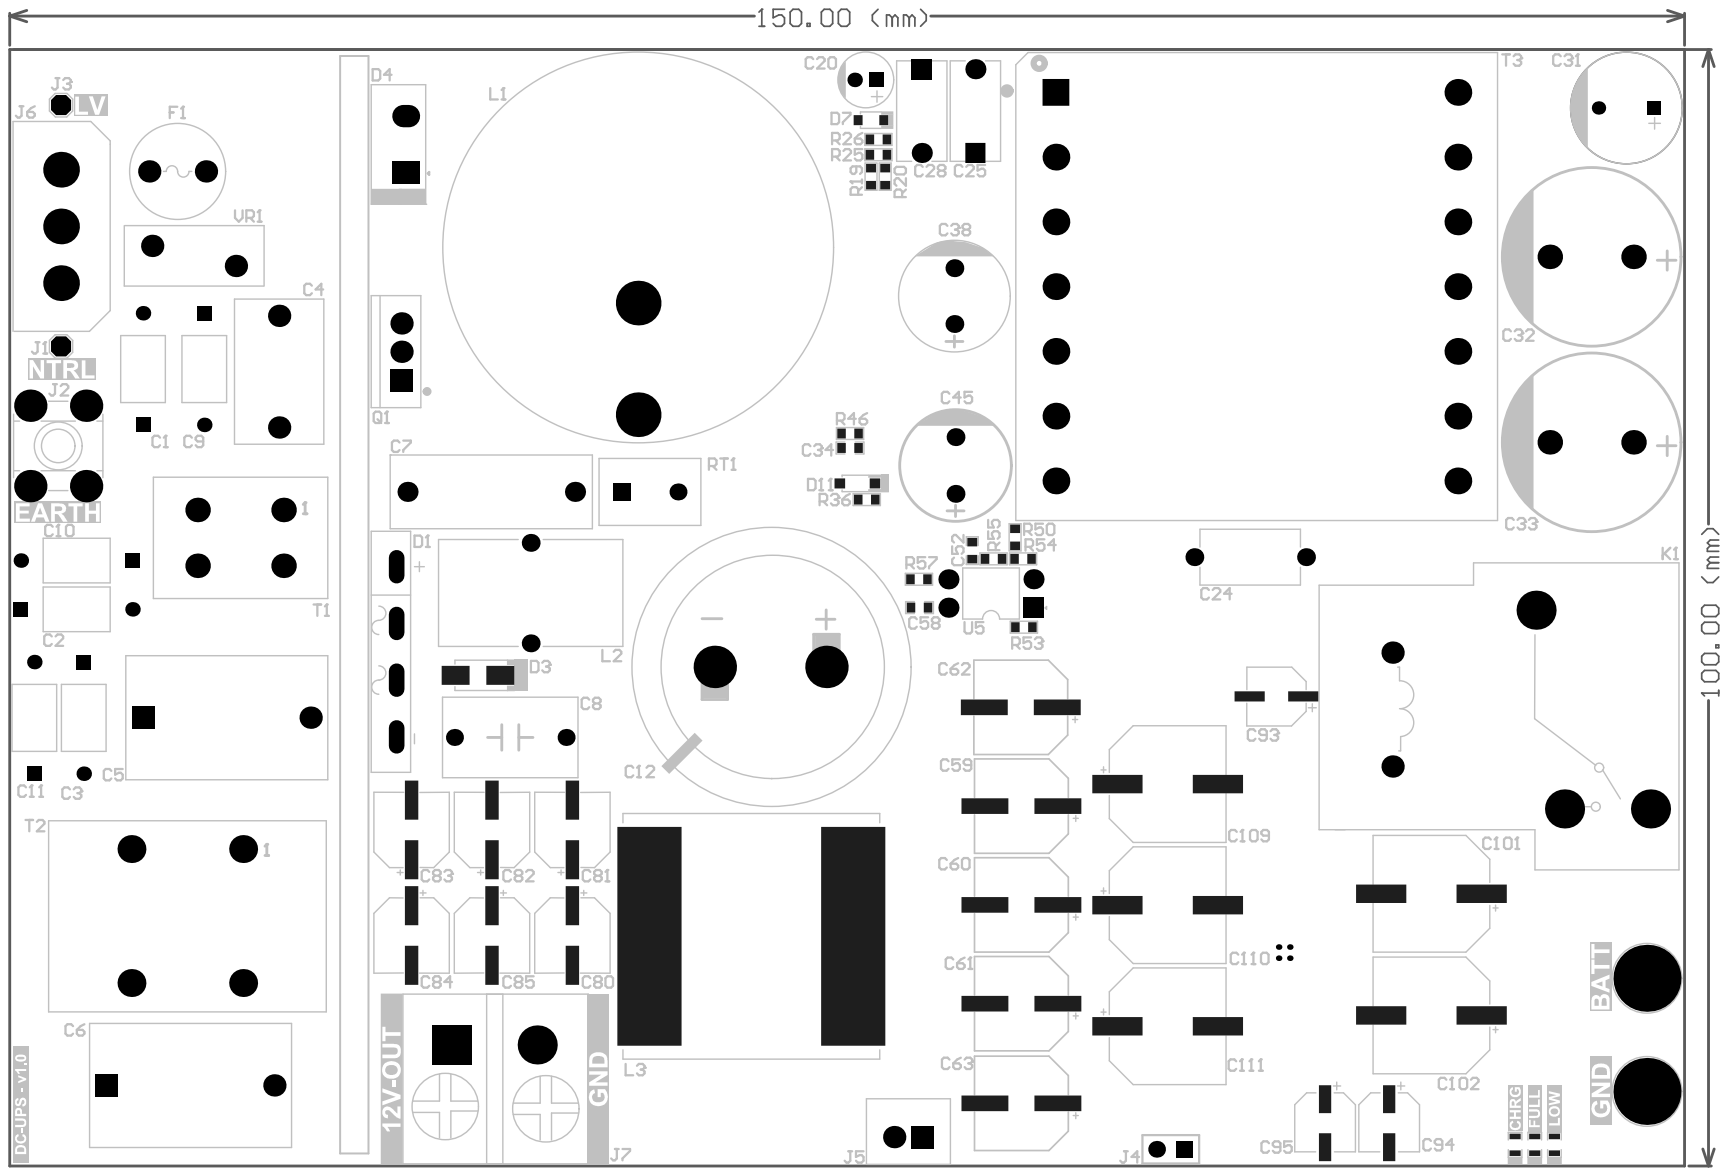
[picture p15: page 1]

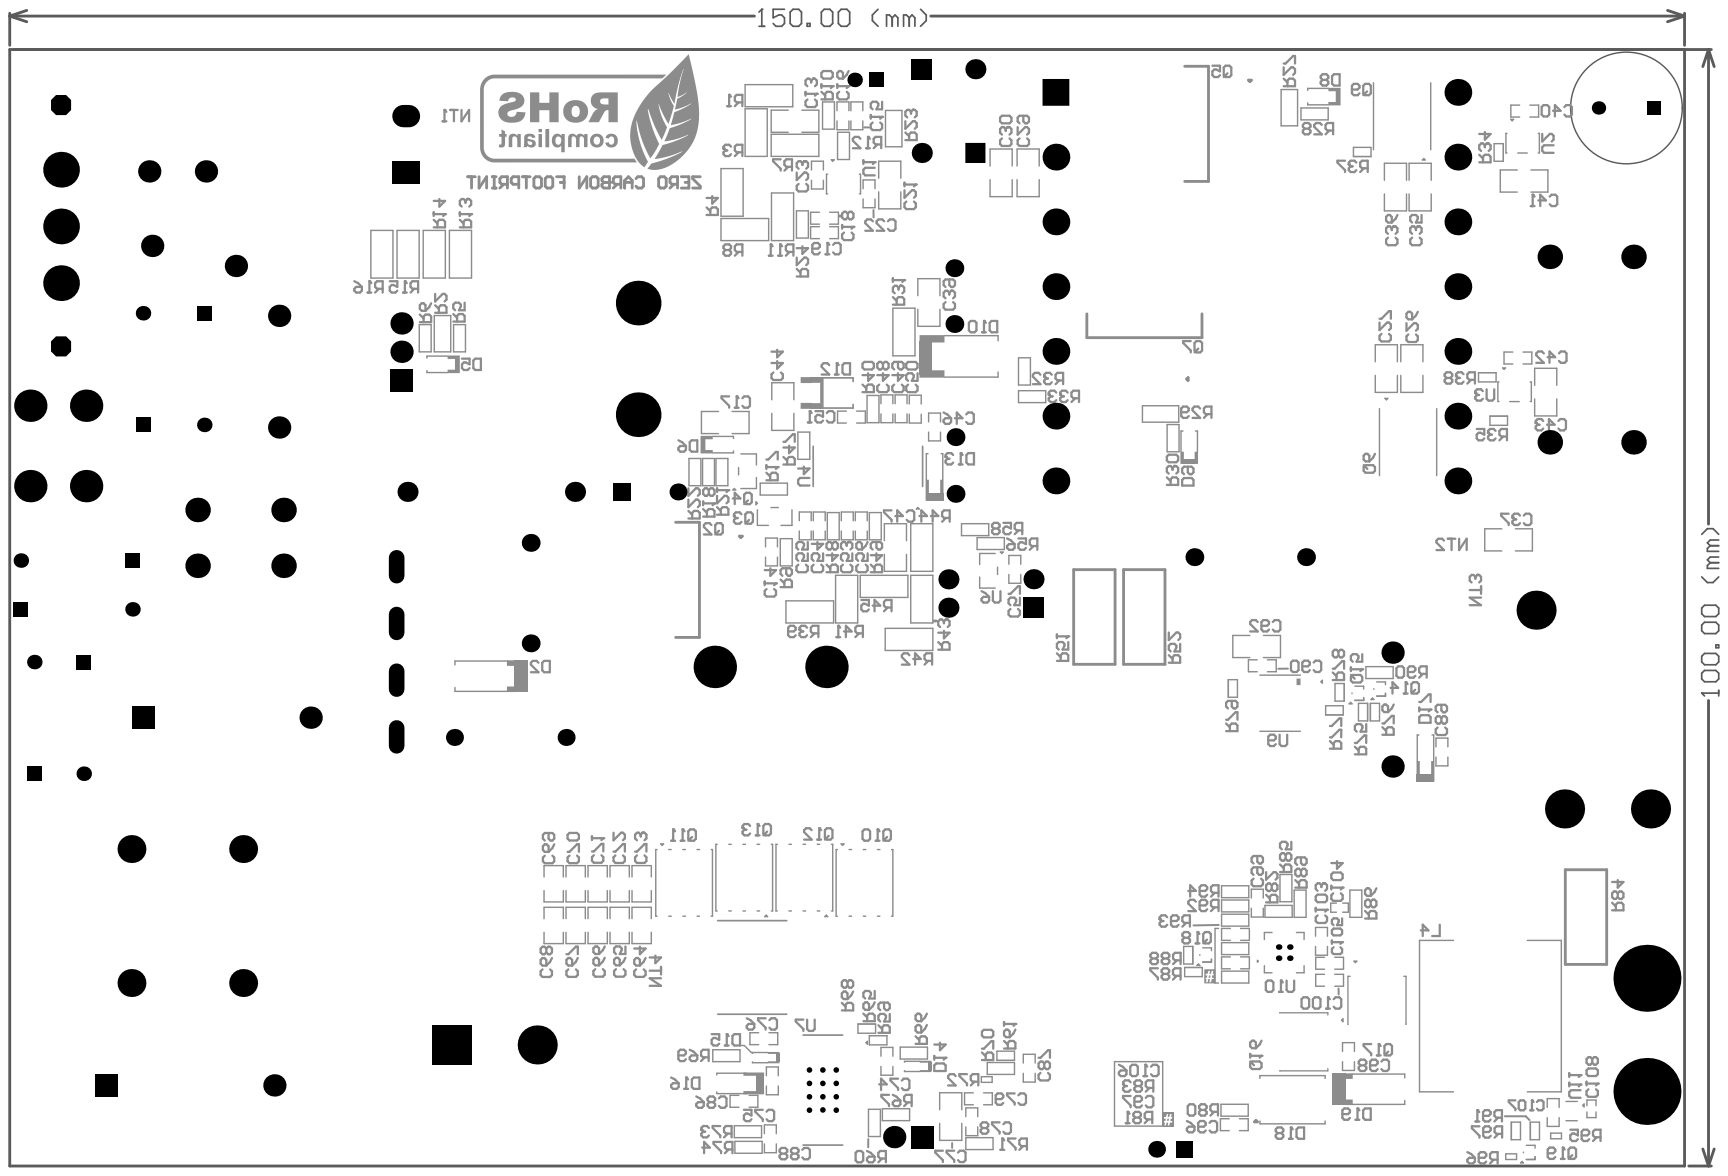
[picture p16: page 2]

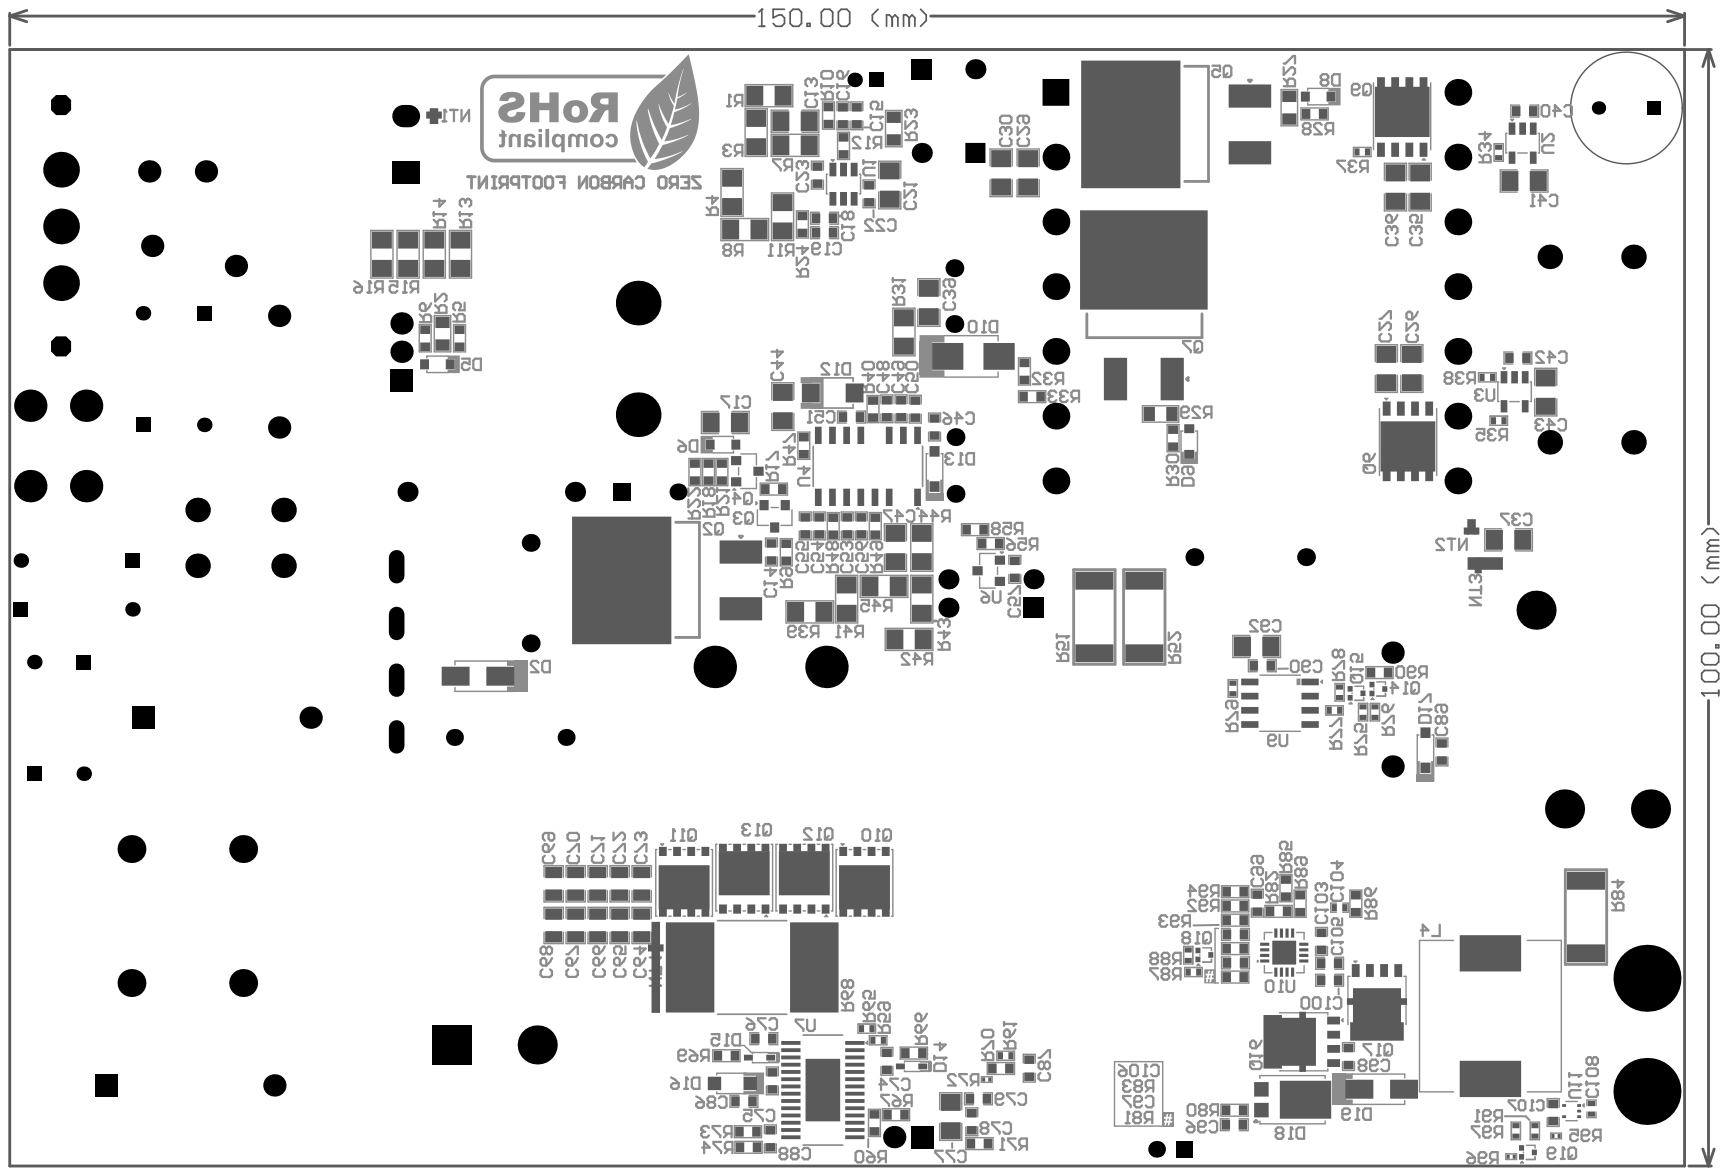
[picture p17: page 4]
