eSpark-Backup/bryangilmore-ups/(list of files, drawings)

Other design files:
Design-Files/DC-UPS-v1.0/Design-Files/Buck-Boost-Sheet.SchDoc
Design-Files/DC-UPS-v1.0/Design-Files/Charging-Sheet.SchDoc
Design-Files/DC-UPS-v1.0/Design-Files/DC-UPS-v1.0.PcbDoc
Design-Files/DC-UPS-v1.0/Design-Files/DC-UPS-v1.0.PrjPcb
Design-Files/DC-UPS-v1.0/Design-Files/Power-Sheet-1.SchDoc
Design-Files/DC-UPS-v1.0/Design-Files/Power-Sheet-2.SchDoc
Design-Files/DC-UPS-v1.0/Design-Files/Power-Sheet-3.SchDoc
Design-Files/DC-UPS-v1.0/Design-Files/Relay-Switch-Sheet.SchDoc
