eSpark-Backup/bryangilmore-ups/(commit log)

2024-07-26 #2 AC-DC power side added. In Progress
    [DC-UPS-v1.0.PrjPcb, Power-Sheet-1.SchDoc, Power-Sheet-2.SchDoc, Power-Sheet-3.SchDoc]
2024-07-31 #2 Buck boost relay circuit added
    [Buck-Boost-Sheet.SchDoc, DC-UPS-v1.0.PrjPcb, Power-Sheet-3.SchDoc, Relay-Switch-Sheet.SchDoc]
2024-08-01 #2 Complete - without transformer finalization
    [Buck-Boost-Sheet.SchDoc, Charging-Sheet.SchDoc, DC-UPS-v1.0.PrjPcb, Power-Sheet-1.SchDoc, Power-Sheet-2.SchDoc, Power-Sheet-3.SchDoc, Relay-Switch-Sheet.SchDoc]
2024-08-02 #2 CHRG LEDs added. ON/OFF output functionality added.
    [Buck-Boost-Sheet.SchDoc, Charging-Sheet.SchDoc]
2024-08-02 #3 placement in progress
    [Buck-Boost-Sheet.SchDoc, Charging-Sheet.SchDoc, DC-UPS-v1.0.PcbDoc, DC-UPS-v1.0.PrjPcb, Power-Sheet-1.SchDoc, Relay-Switch-Sheet.SchDoc]
2024-08-05 Schematic PDF pushed #2
2024-08-07 #2 J6 Connector added.
    [Power-Sheet-1.SchDoc]
2024-08-07 #3 Placement in Prrogress
    [DC-UPS-v1.0.PcbDoc]
2024-08-09 #3 #2 DBT50G-7.62-2P-BK-P added in Schematic and Placement in progress
    [Buck-Boost-Sheet.SchDoc, DC-UPS-v1.0.PcbDoc, DC-UPS-v1.0.PrjPcb]
2024-08-12 #3 Placement complete but, designator setting and capacitor at transformer is remaining
    [DC-UPS-v1.0.PcbDoc]
2024-08-15 #3 capacitor re-added dur to missing footprint, Placement completed
    [DC-UPS-v1.0.PcbDoc, Power-Sheet-2.SchDoc, Relay-Switch-Sheet.SchDoc]
2024-08-19 #2 Inductor, Transformer and other required changes done. PDF pushed
    [Buck-Boost-Sheet.SchDoc, Charging-Sheet.SchDoc, DC-UPS-v1.0.PrjPcb, Power-Sheet-1.SchDoc, Power-Sheet-3.SchDoc]
2024-08-21 #2 Pushing two sheets again.
    [DC-UPS-v1.0.PrjPcb, Power-Sheet-2.SchDoc, Relay-Switch-Sheet.SchDoc]
2024-08-21 #2 R13 - R16 updated.
    [Power-Sheet-1.SchDoc]
2024-08-22 #3 Placement completed
    [DC-UPS-v1.0.PcbDoc]
2024-08-23 #3 Routing in progress
    [DC-UPS-v1.0.PcbDoc]
2024-08-27 #3 Routing completed
    [DC-UPS-v1.0.PcbDoc, DC-UPS-v1.0.PrjPcb]
2024-08-27 #2 Netlable updated to 12V-out C31 re-added due to footprint missing issue
    [Buck-Boost-Sheet.SchDoc, DC-UPS-v1.0.PcbDoc, Power-Sheet-2.SchDoc]
2024-08-28 #3 modified some tracks and Vias added for BAT
    [DC-UPS-v1.0.PcbDoc]
2024-08-28 #3 PCB updated with C25, C28
    [DC-UPS-v1.0.PcbDoc]
2024-08-29 #4 Client BOM added.
    [Client-BOM-DC-UPS-v1.0.xlsx]
2024-08-30 #4 Peripheral Added
    @basit-eSpark FYI
    [Client-BOM-DC-UPS-v1.0.xlsx]
2024-08-30 #5 #3 Review of the design is in progress.
    [DC-UPS-v1.0.PcbDoc]
2024-09-02 #2 Q6 and Q9 footprint was changed, so replaced it in schematic. (No change)
    [Power-Sheet-2.SchDoc]
2024-09-02 #3 #5 Review paused, Layout changes need to be done sidra. Will review once the changes are done.
    [DC-UPS-v1.0.PcbDoc]
2024-09-13 #9 Changes in PCB In-progress.
    [Buck-Boost-Sheet.SchDoc, Charging-Sheet.SchDoc, DC-UPS-v1.0.PcbDoc, DC-UPS-v1.0.PrjPcb, Power-Sheet-1.SchDoc, Power-Sheet-2.SchDoc, Power-Sheet-3.SchDoc, Relay-Switch-Sheet.SchDoc]
2024-09-16 #5 Deliverables generated including Client BOM.
    [Buck-Boost-Sheet.SchDoc, Centroid_File-v1.0.csv, Charging-Sheet.SchDoc, Client-BOM-DC-UPS-v1.0.xlsx, DC-UPS-v1.0.DWG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]
